NgoAnThuyen/MotorControlBasedOnESP8266AndBlynk/README.md

# MotorControlBasedOnESP8266AndBlynk
> Link youtube [here](https://youtu.be/FkxOS0iufPw)
